Qt-mini/Qt-miniProject/image/qt_design.pdf

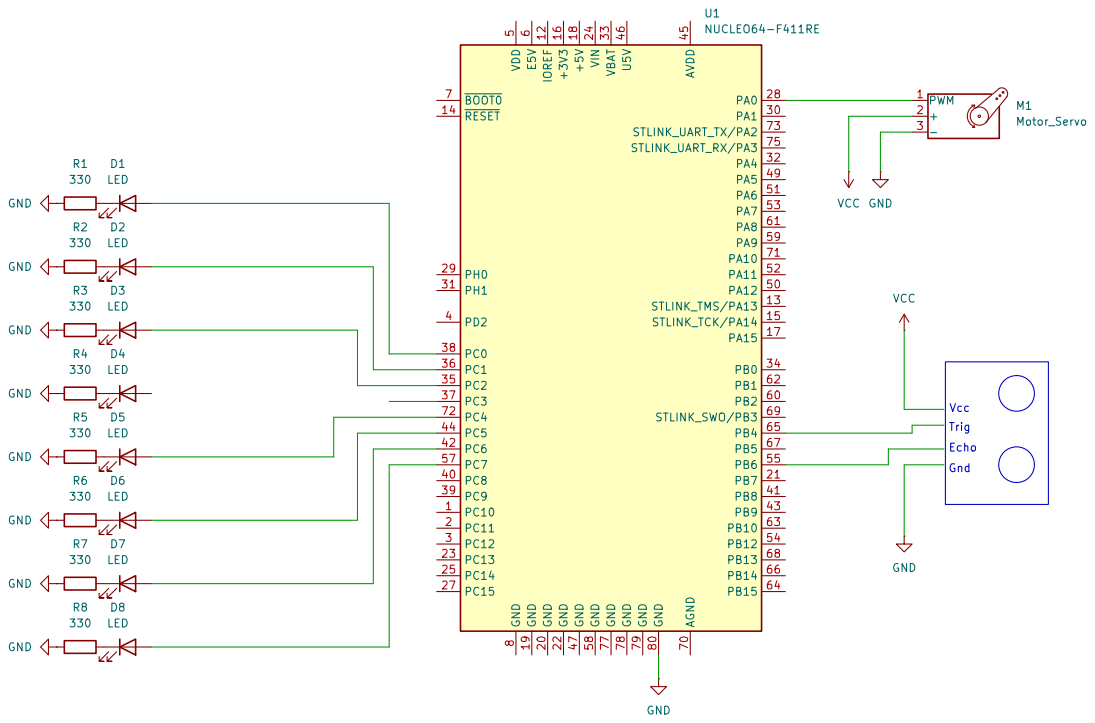
[picture p2: page 1]
