Qt-mini/Qt-miniProject/(commit log)

2026-08-14 초기 파일 구성
2026-08-16 chore: main.c 초기파일 구성
2026-08-17 feat: servo_motor.c 파일 추가 - 서보모터 초기화 구현 - 차단기 오픈 함수 구현 - 차단기 닫기 함수 구현
2026-08-17 feat: servo_motor.c 수정 - 차단기 열고닫는 로직 병합
    [servo_motor.c]
2026-08-17 feat: led_slot.c 추가 - 비어있는 곳부터 층수반환하는 로직 추가
2026-08-17 feat: led.c 구현 - led 초기설정 구현 - 입차, 출차시 led 로직 구현
2026-08-17 feat: timer.c 타이머 수정 - 딜레이 타이머 3번으로 구현 및 불필요한 코드 삭제
    [timer.c]
2026-08-17 feat: led_slot.c 함수 수정 - Slot_SetOccupied, Slot_SetEmpty 구현 - getter구현 - 올바르지 못한 층 입력시 에러 추가
    [led_slot.c]
2026-08-17 feat: 함수 주석 추가
2026-08-17 fix: led.slot.c 변수명 수정
    [led_slot.c]
2026-08-18 fix: servo_motor.c 수정 - 비트연산 메크로 작업 및 오타 수정
    [servo_motor.c]
2026-08-18 fix: led.c 수정 - led_init함수 led초기화 내부 메크로 수정
    [led.c]
2026-08-18 fix: LED 버그 수정
    [device_driver.h, led.c, led_slot.c, main.c, timer.c, uart.c]
2026-08-18 fix: 서보모터 동작
2026-08-18 fix: 차단기 동작 개선
    [main.c, servo_motor.c, uart.c, ultrasonic.c, ultrasonic.h]
2026-08-18 doc: README 수정 - ui구현 예상도 사진파일 추가 - 하드웨어 회로도 추가
2026-08-18 dox: README 수정
2026-08-19 doc README 함수, 변수명세서 수정
2026-08-19 doc: README.md 설계서 수정
2026-08-19 doc: 함수명세서 수정
2026-08-19 doc:README 제목수정
2026-08-19 doc: README 수정 - pdf기준 단락 분리
2026-08-19 doc: README 세부구현목록 수정
2026-08-19 doc: README 텍스트파일 수정
2026-08-19 doc: 설계서 함수목록 수정
2026-08-19 doc: 타이머 함수 목록 수정
2026-08-19 doc: 서보모터 함수목록 수정
2026-08-19 feat: Qt 파일 추가
